JEstebanRM/Proyecto_Spyder/Informe_Final_Y_Presentacion/Link.txt

https://www.youtube.com/watch?v=vpToblc9TF4
