JEstebanRM/Proyecto_Spyder/Informe_Final_Y_Presentacion/Planos_SPYDER.pdf

NUMERO | DESCRIPCION | CANTIDAD 1 | LARGUEROS | 12 2 | RODAMIENTO | 12 3 | EJE RODA | 12 4 | PLACA 1 | 2 5 | SOPORTE 1 | 2 6 | RODA LINEAL | 2 7 | MOTOR | 2 8 | EJE Z | 2 9 | PLACA 2 | 1
1

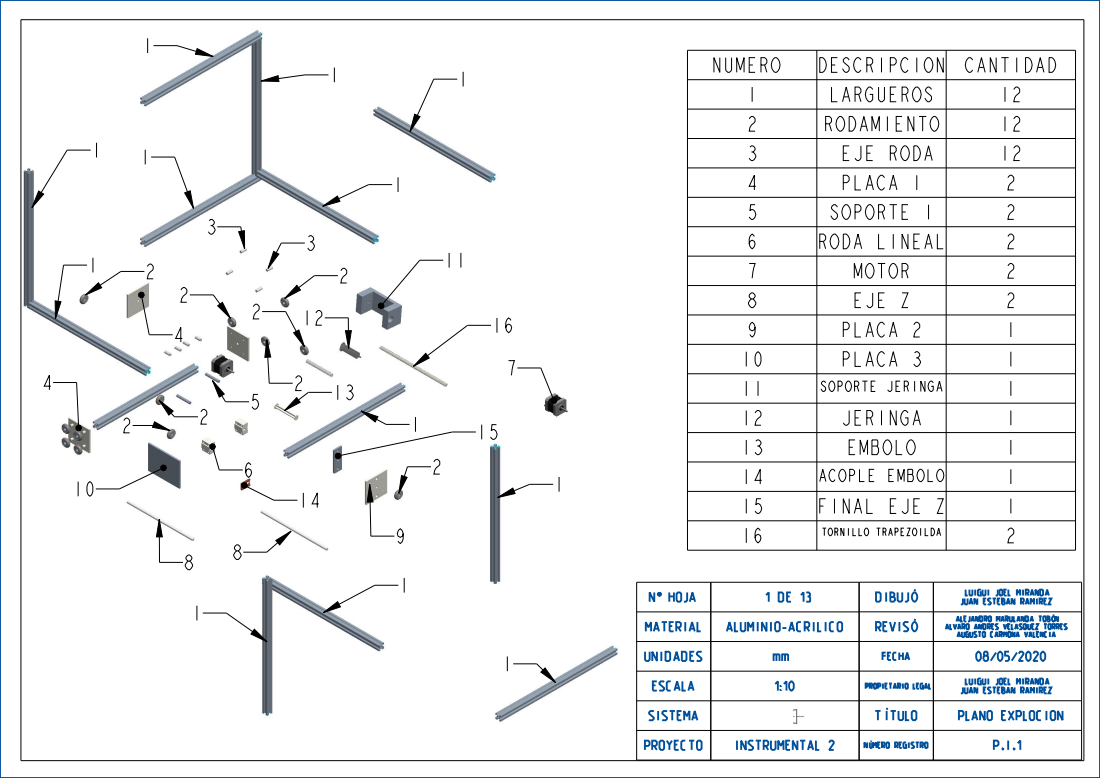
[picture p22: page 1]
FECHA; TÍTULO; INSTRUMENTAL 2; HOJA; SISTEMA; JUAN; ESTEBAN RAMIREZ

10 | PLACA 3 | 1
11 | | SOPORTE JERINGA | | 1
12 | JERINGA | | 1
13 | EMBOLO | | 1
14 | ACOPLE EMBOLO | | 1
15 | FINAL EJE Z | | 1
16 | | TORNILLO TRAPEZOILDA | | | 2

1 DE 13 | DIBUJÓ

LUIGUI JOEL MIRANDA

MATERIAL | | ALUMINIO-ACRILICO | | | REVISÓ | ALEJANDRO MARULANDA TOBÓN ALVARO ANDRES VELASQUEZ TORRES AUGUSTO CARMONA VALENCIA
UNIDADES | | | | | 08/05/2020

ESCALA | 1:10 | | PROPIETARIO LEGAL

PLANO EXPLOCION

PROYECTO | | | | NÚMERO REGISTRO | | | P.I.1

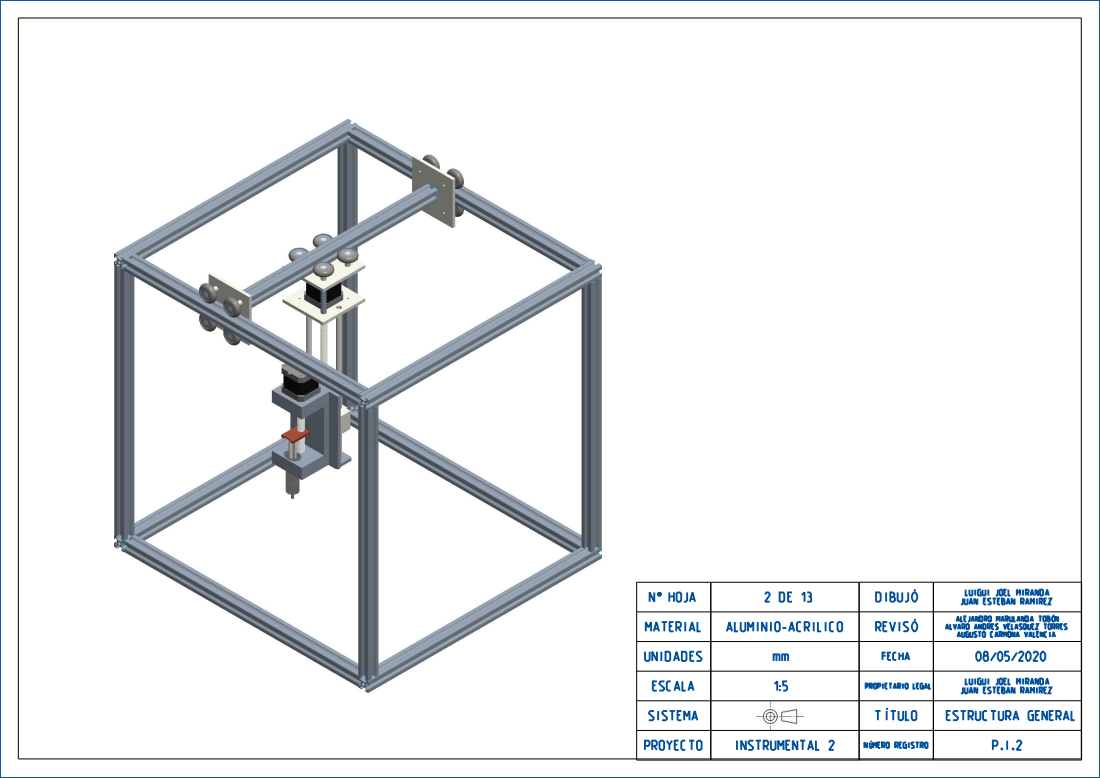
[picture p23: page 2]
FECHA; TÍTULO; HOJA; SISTEMA; JUAN; ESTEBAN RAMIREZ

2 DE 13 | DIBUJÓ

LUIGUI JOEL MIRANDA

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

ESCALA | 1:5 | | PROPIETARIO LEGAL

ESTRUCTURA GENERAL

20

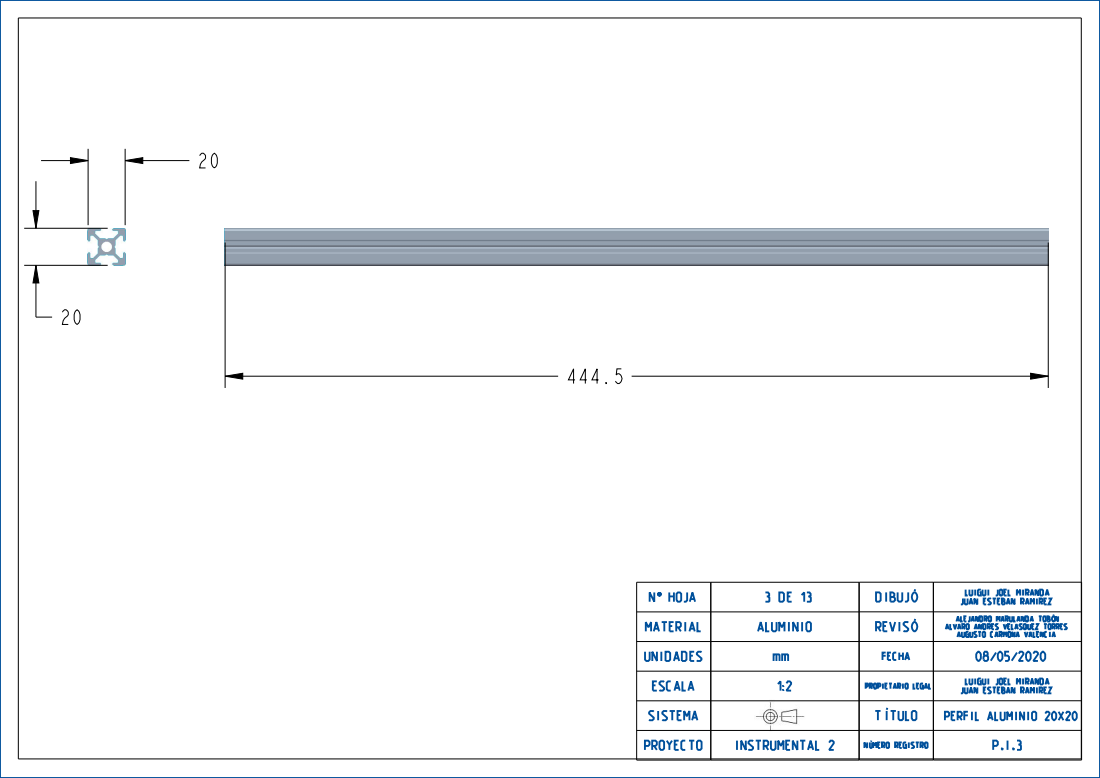
[picture p24: page 3]
FECHA; TÍTULO; HOJA; SISTEMA; JUAN; ESTEBAN RAMIREZ

3 DE 13 | DIBUJÓ

LUIGUI JOEL MIRANDA

MATERIAL | | ALUMINIO | | REVISÓ | ALEJANDRO MARULANDA TOBÓN ALVARO ANDRES VELASQUEZ TORRES AUGUSTO CARMONA VALENCIA
UNIDADES | | | | | 08/05/2020

ESCALA | 1:2 | | PROPIETARIO LEGAL

PERFIL ALUMINIO 20X20

382.5

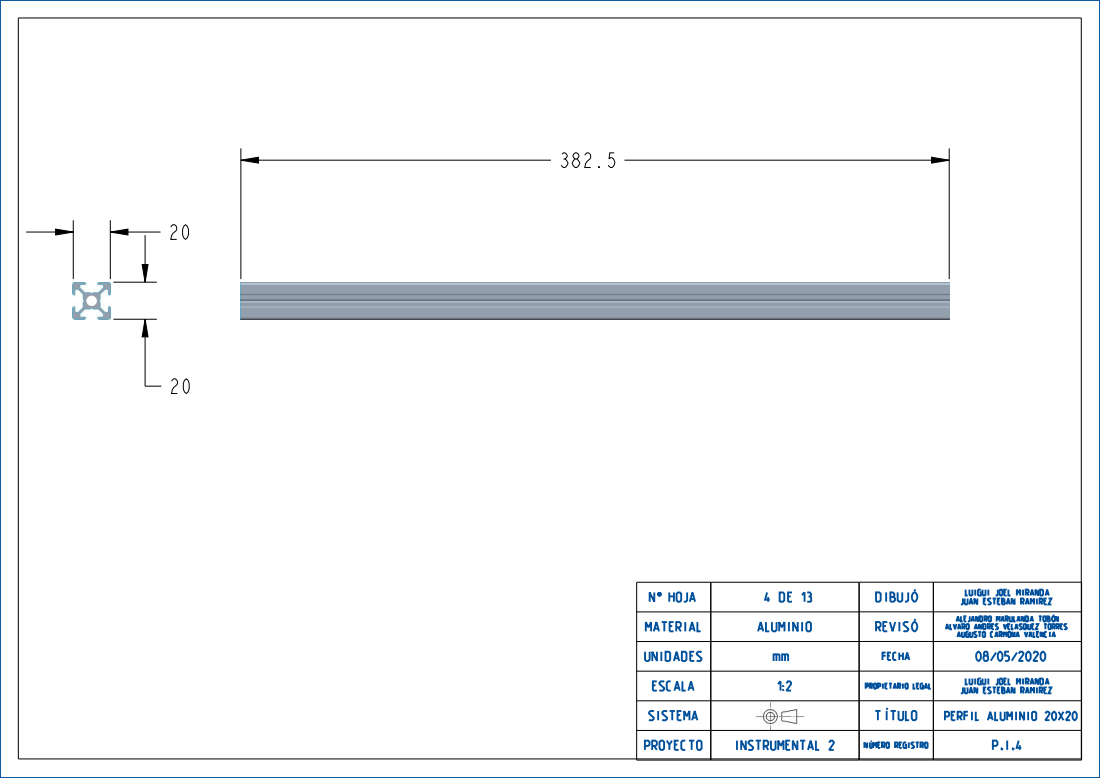
[picture p25: page 4]
FECHA; TÍTULO; HOJA; SISTEMA; JUAN; ESTEBAN RAMIREZ

4 DE 13 | DIBUJÓ

LUIGUI JOEL MIRANDA

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

ESCALA | 1:2 | | PROPIETARIO LEGAL

PERFIL ALUMINIO 20X20

R14.5

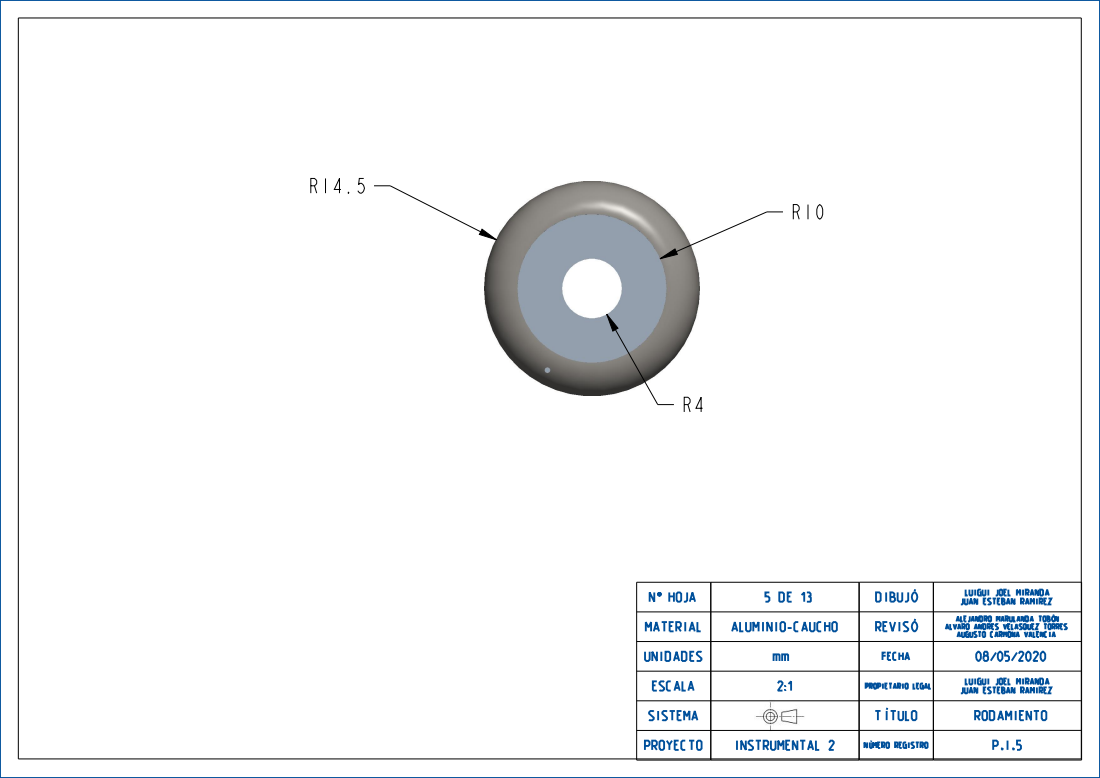
[picture p26: page 5]
FECHA; TÍTULO; HOJA; SISTEMA; JUAN; ESTEBAN RAMIREZ

5 DE 13 | DIBUJÓ

LUIGUI JOEL MIRANDA

MATERIAL | | ALUMINIO-CAUCHO | | REVISÓ | | ALEJANDRO MARULANDA TOBÓN ALVARO ANDRES VELASQUEZ TORRES AUGUSTO CARMONA VALENCIA
UNIDADES | | | | | 08/05/2020

ESCALA | 2:1 | | PROPIETARIO LEGAL

RODAMIENTO

R4

20

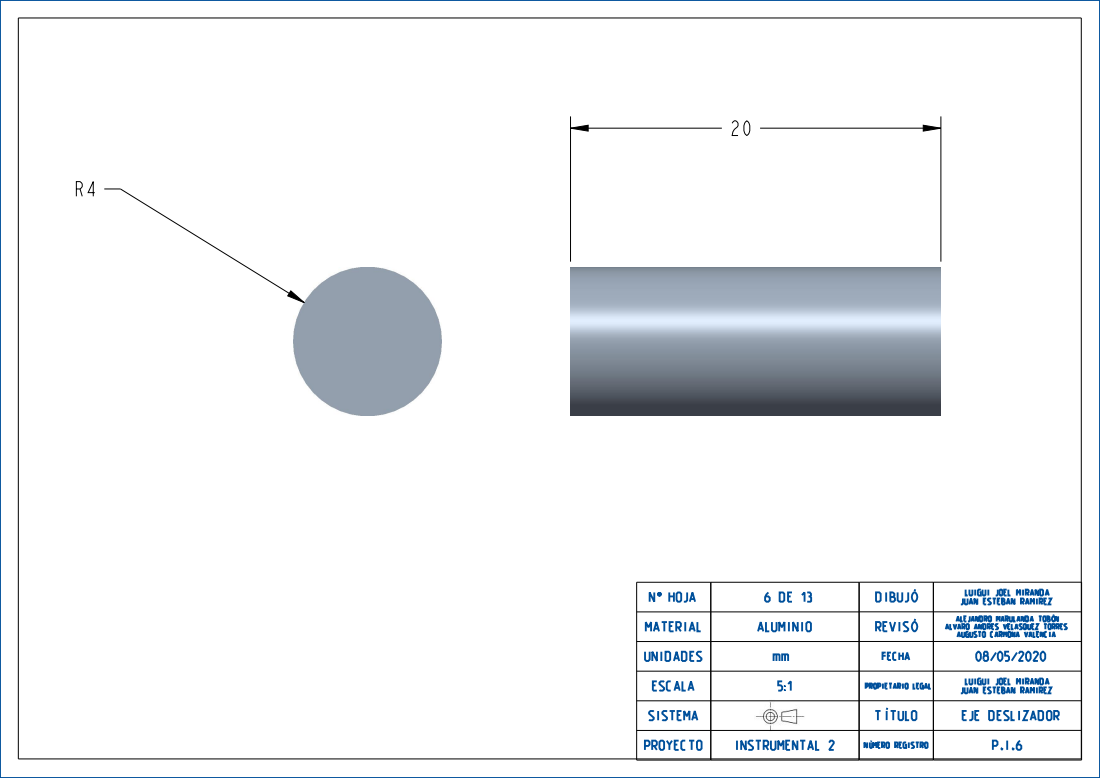
[picture p27: page 6]
FECHA; TÍTULO; HOJA; SISTEMA; JUAN; ESTEBAN RAMIREZ

6 DE 13 | DIBUJÓ

LUIGUI JOEL MIRANDA

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

ESCALA | 5:1 | | PROPIETARIO LEGAL

EJE DESLIZADOR

80

R1.5X4

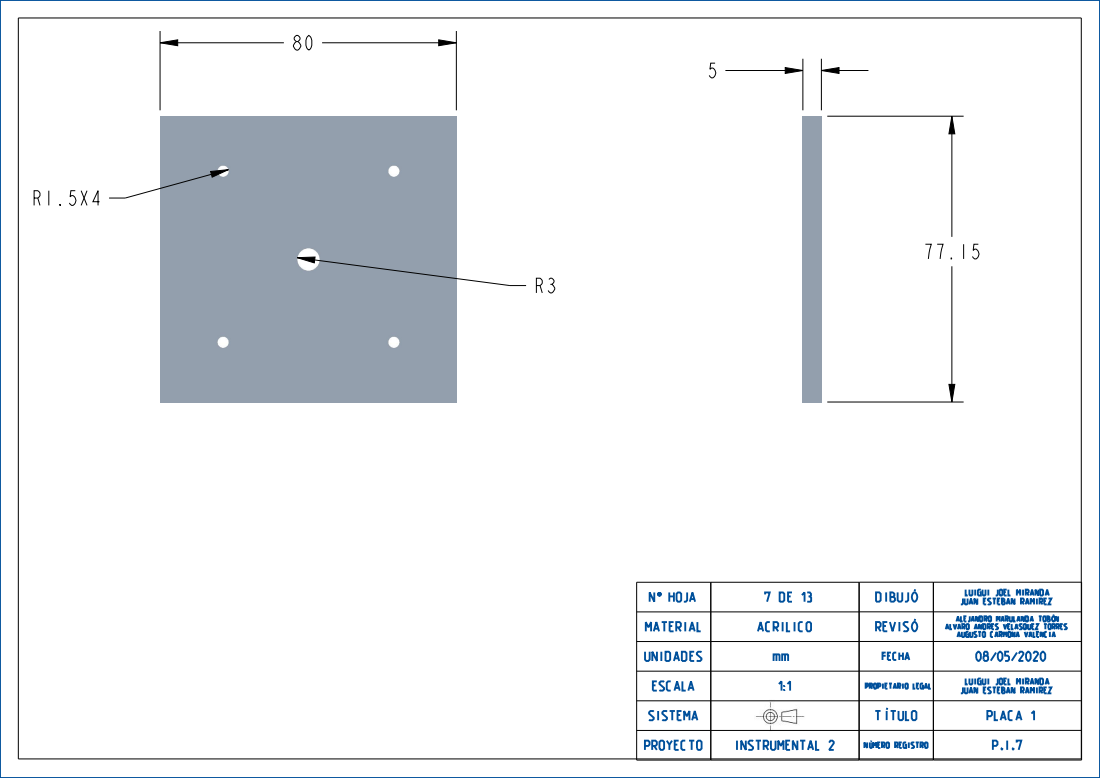
[picture p28: page 7]
FECHA; TÍTULO; HOJA; SISTEMA; JUAN; ESTEBAN RAMIREZ

7 DE 13 | DIBUJÓ

LUIGUI JOEL MIRANDA

MATERIAL | | ACRILICO | | REVISÓ | ALEJANDRO MARULANDA TOBÓN ALVARO ANDRES VELASQUEZ TORRES AUGUSTO CARMONA VALENCIA
UNIDADES | | | | | 08/05/2020

ESCALA | 1:1 | | PROPIETARIO LEGAL

PLACA 1

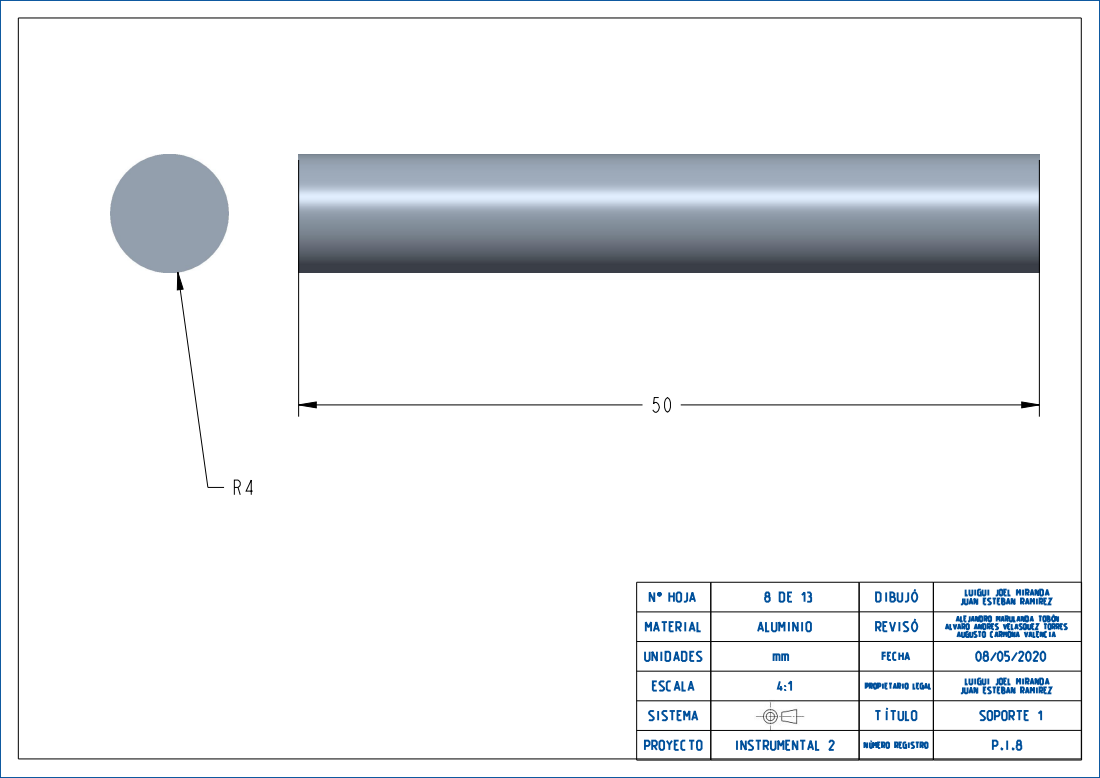
[picture p29: page 8]
FECHA; TÍTULO; HOJA; SISTEMA; JUAN; ESTEBAN RAMIREZ

8 DE 13 | DIBUJÓ

LUIGUI JOEL MIRANDA

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

ESCALA | 4:1 | | PROPIETARIO LEGAL

SOPORTE 1

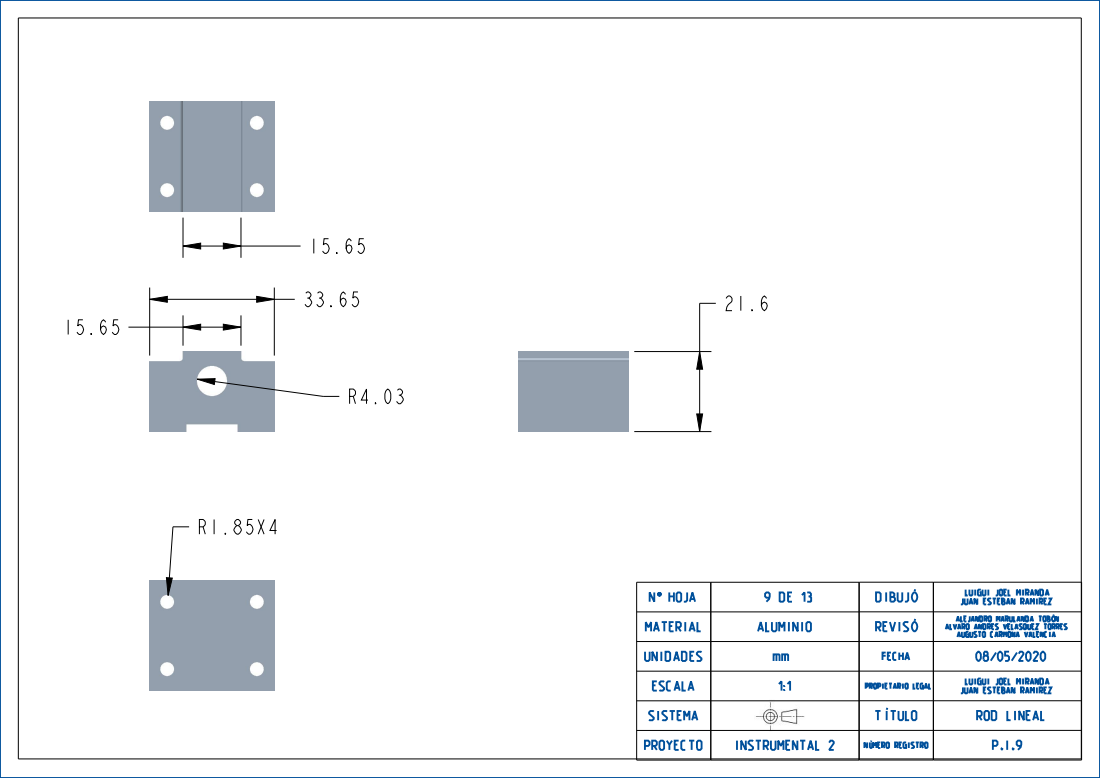
[picture p30: page 9]
FECHA; TÍTULO; HOJA; SISTEMA; JUAN; ESTEBAN RAMIREZ

9 DE 13 | DIBUJÓ

LUIGUI JOEL MIRANDA

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

ESCALA | 1:1 | | PROPIETARIO LEGAL

ROD LINEAL

250

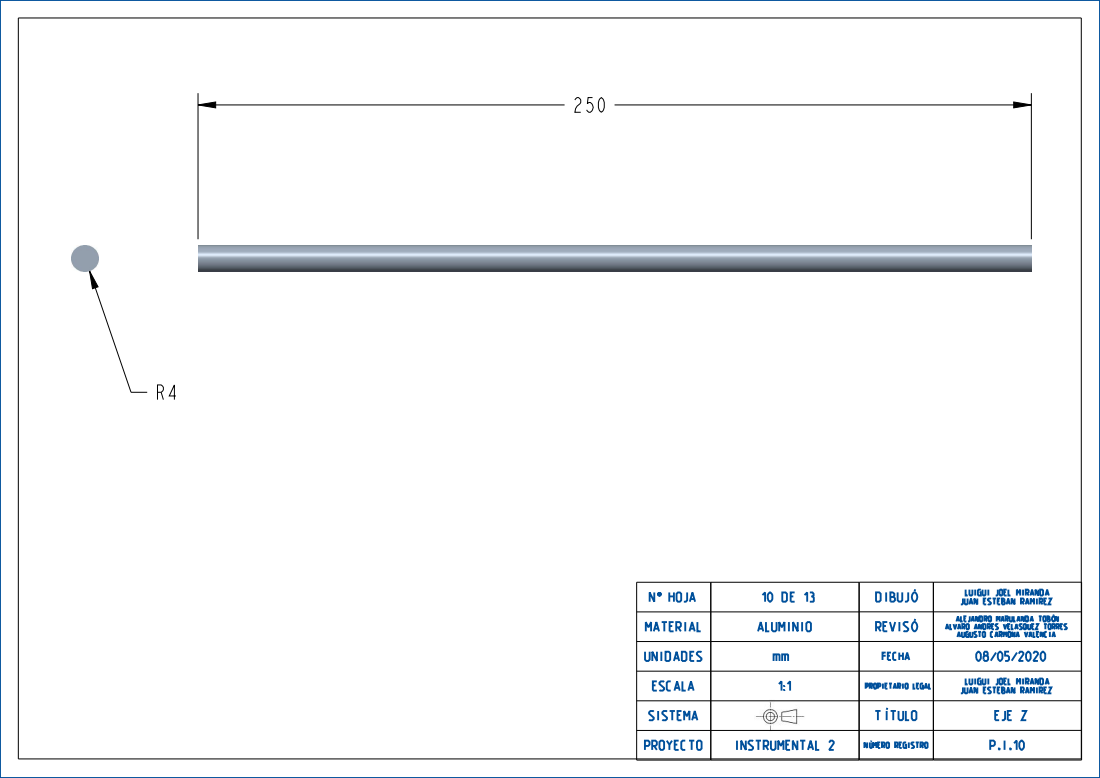
[picture p31: page 10]
FECHA; TÍTULO; HOJA; SISTEMA; JUAN; ESTEBAN RAMIREZ

10 DE 13 | DIBUJÓ

LUIGUI JOEL MIRANDA

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

ESCALA | 1:1 | | PROPIETARIO LEGAL

EJE Z

R11
R4

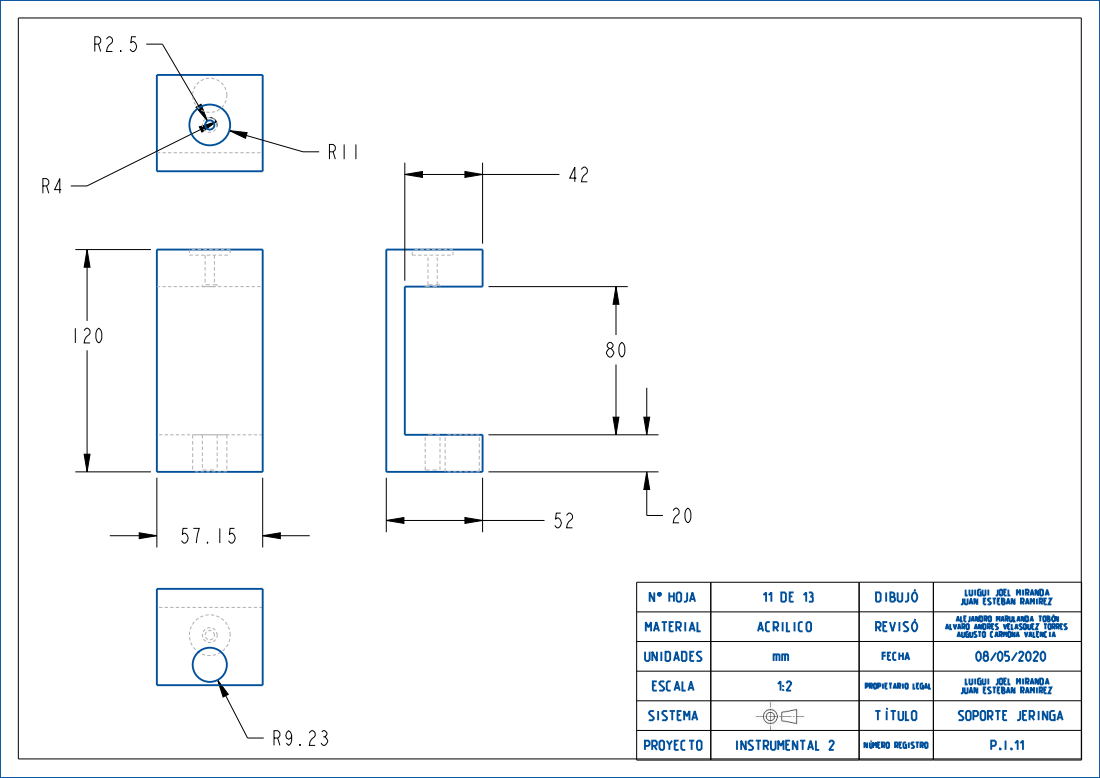
[picture p32: page 11]
FECHA; TÍTULO; HOJA; SISTEMA; JUAN; ESTEBAN RAMIREZ

11 DE 13 | DIBUJÓ

LUIGUI JOEL MIRANDA

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

ESCALA | 1:2 | | PROPIETARIO LEGAL

SOPORTE JERINGA

22

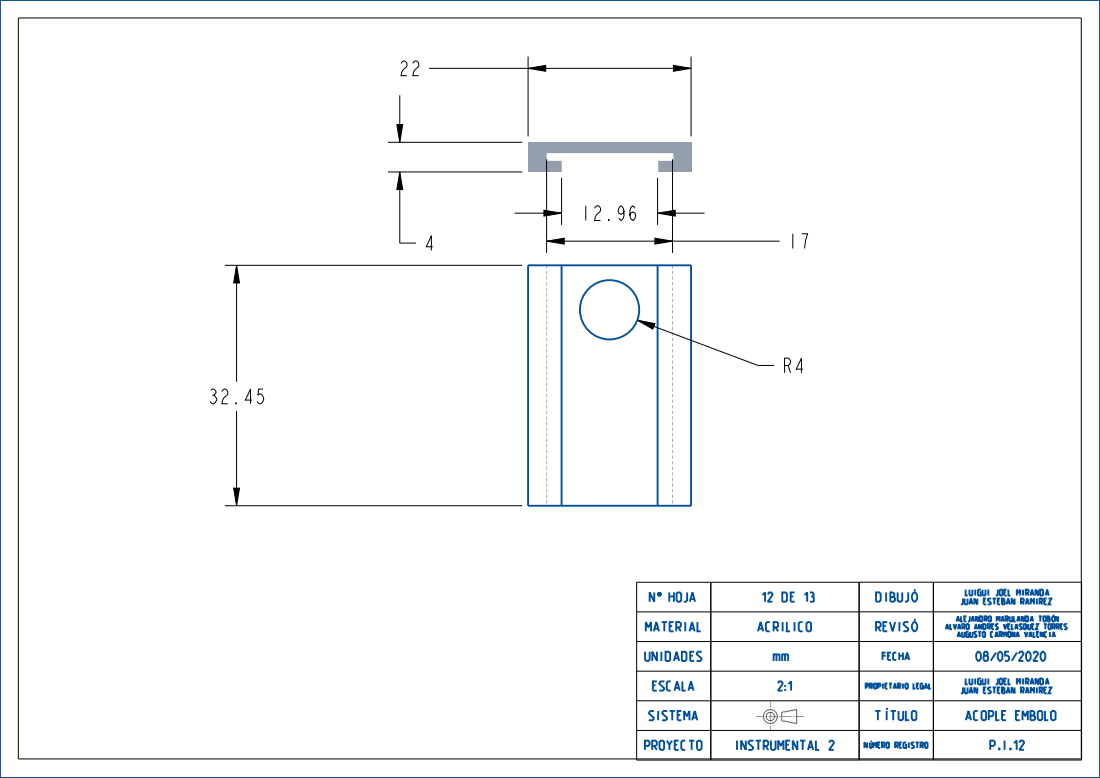
[picture p33: page 12]
FECHA; TÍTULO; HOJA; SISTEMA; JUAN; ESTEBAN RAMIREZ

12 DE 13 | DIBUJÓ

LUIGUI JOEL MIRANDA

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

ESCALA | 2:1 | | PROPIETARIO LEGAL

ACOPLE EMBOLO

77.15

5

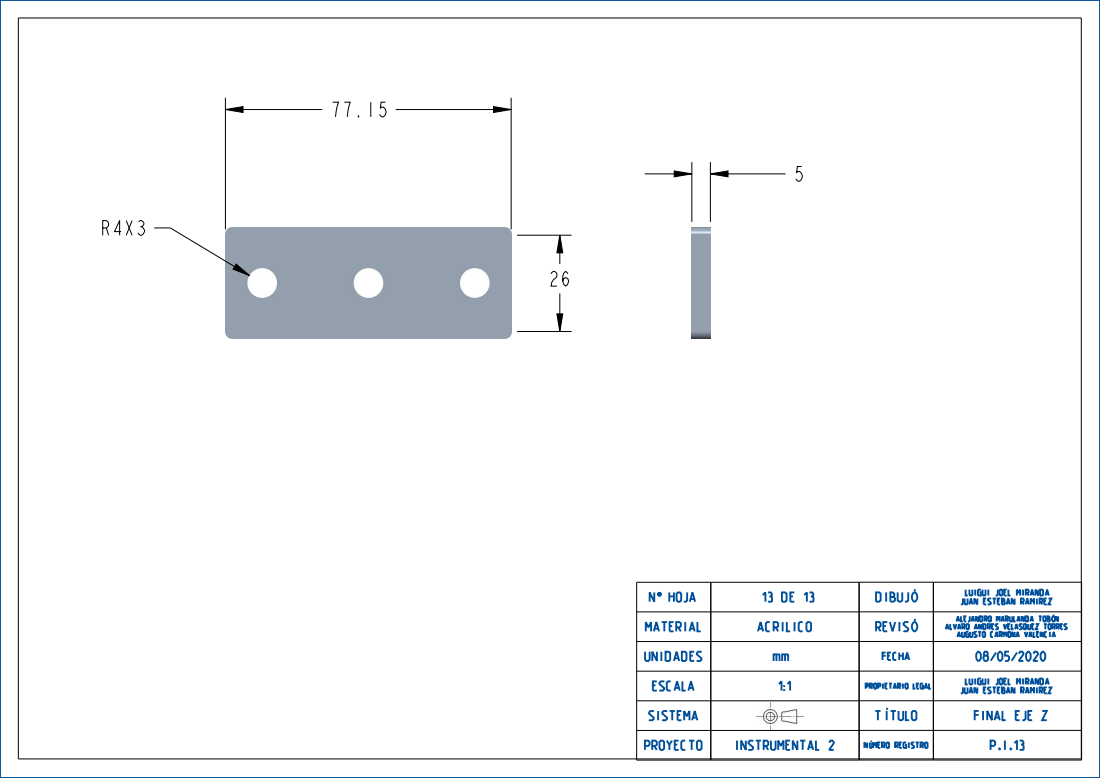
[picture p34: page 13]
FECHA; TÍTULO; HOJA; SISTEMA; JUAN; ESTEBAN RAMIREZ

13 DE 13 | DIBUJÓ

LUIGUI JOEL MIRANDA

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

ESCALA | 1:1 | | PROPIETARIO LEGAL

FINAL EJE Z
