JEstebanRM/Proyecto_Spyder/(list of files, drawings)

Other design files:
Informe_Final_Y_Presentacion/Pantalla_Y_Teclado.pdsprj
